Kigazuto/A-quadruped-robot-designed-based-on-a-crank-rocker-mechanism/README.md

# A-quadruped-robot-designed-based-on-a-crank-rocker-mechanism
