Kigazuto/A-quadruped-robot-designed-based-on-a-crank-rocker-mechanism/模型/蜘蛛/带传动/带传动.SLDASM

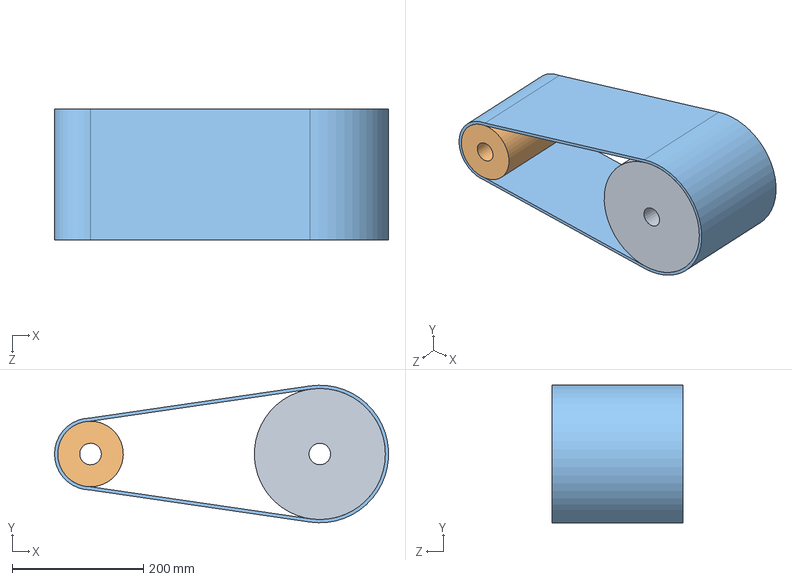
[picture p19: CAD file, 2024-10-21]
模型/蜘蛛/带传动/带传动.SLDASM
509.8 x 210.0 x 200.0 mm
摩擦带
从动轮
主动轮
