Kigazuto/A-quadruped-robot-designed-based-on-a-crank-rocker-mechanism/模型/四足/装配体2.SLDASM

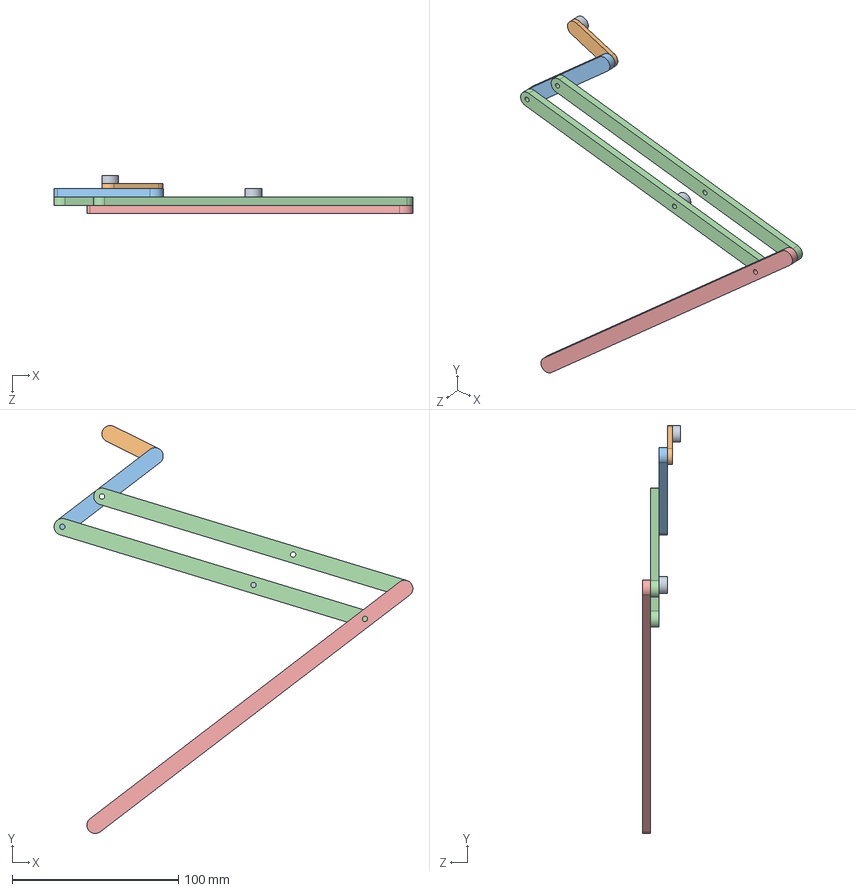
[picture p20: CAD file, 2024-10-21]
模型/四足/装配体2.SLDASM
215.6 x 245.1 x 23.0 mm
固定 x 2
零件1
零件2
零件3 x 2
零件4
