Kigazuto/A-quadruped-robot-designed-based-on-a-crank-rocker-mechanism/模型/蜘蛛/结构简图/草图.SLDASM

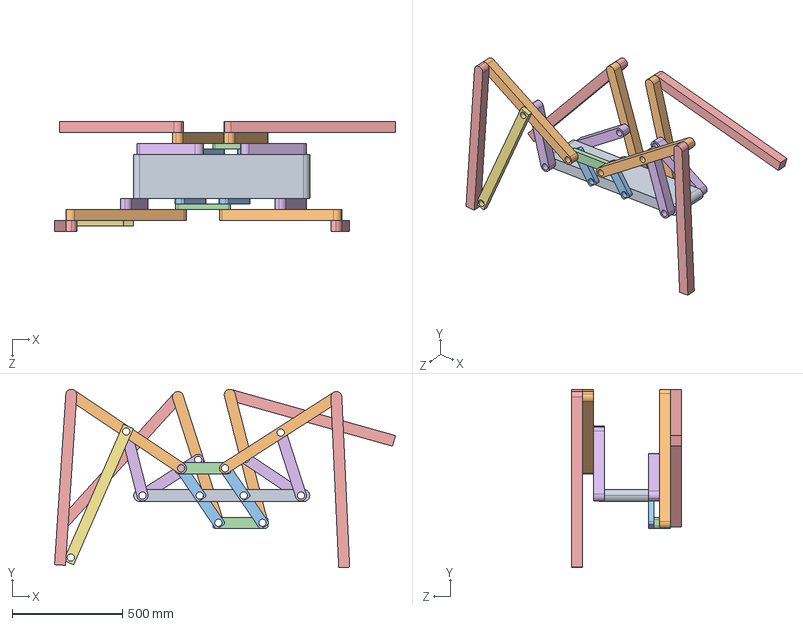
[picture p21: CAD file, 2024-10-21]
模型/蜘蛛/结构简图/草图.SLDASM
1548.7 x 810.5 x 500.0 mm
连杆1
连杆5 x 4
连杆2 x 4
连杆三 x 2
腿 x 4
连杆4 x 4
