Kigazuto/A-quadruped-robot-designed-based-on-a-crank-rocker-mechanism/模型/四足/装配体3.SLDASM

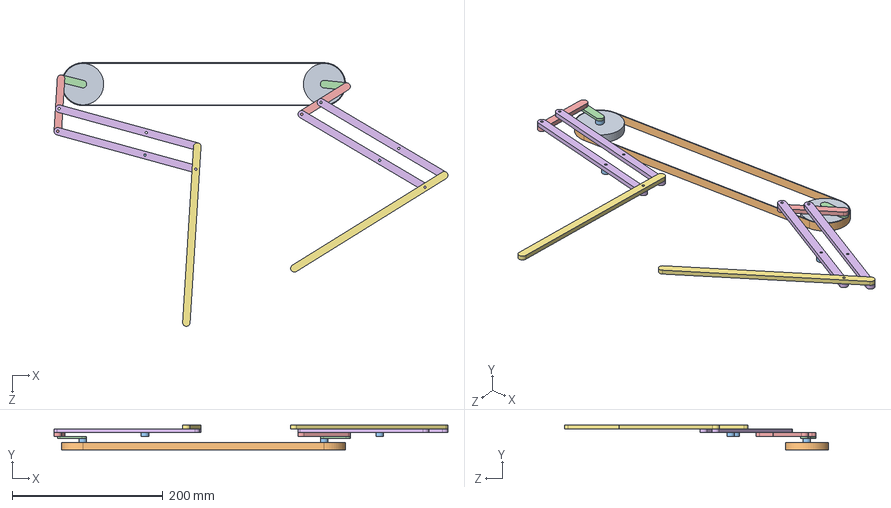
[picture p22: CAD file, 2024-10-21]
模型/四足/装配体3.SLDASM
522.8 x 33.0 x 349.8 mm
轮 x 2
带
固定 x 4
零件1 x 2
零件2 x 2
零件3 x 4
零件4 x 2
