Kigazuto/A-quadruped-robot-designed-based-on-a-crank-rocker-mechanism/模型/四足/装配体1.SLDASM

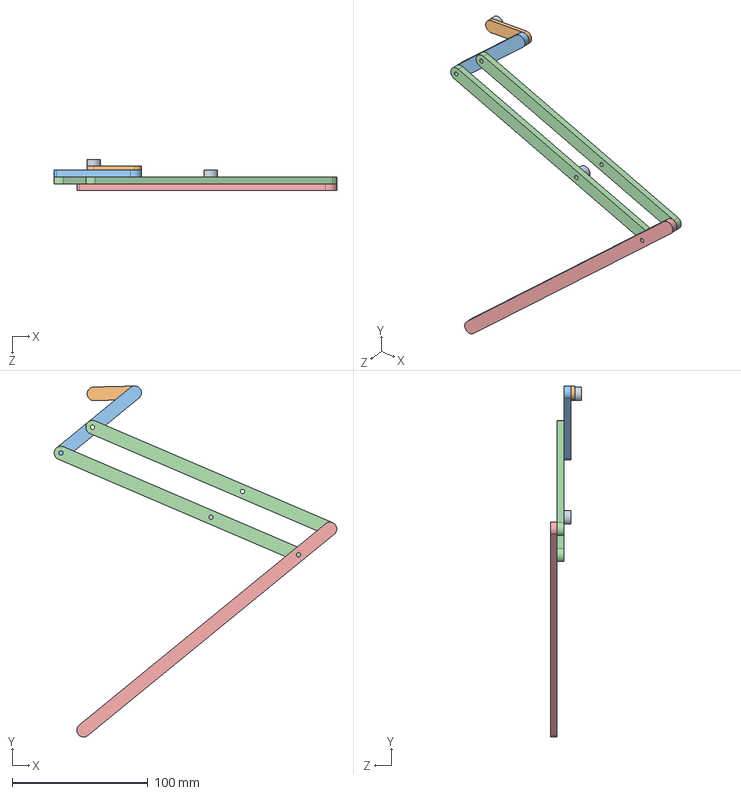
[picture p23: CAD file, 2024-10-21]
模型/四足/装配体1.SLDASM
207.9 x 258.2 x 23.0 mm
固定 x 2
零件1
零件2
零件3 x 2
零件4
