Kigazuto/A-quadruped-robot-designed-based-on-a-crank-rocker-mechanism/模型/蜘蛛/带传动/主动轮.SLDPRT

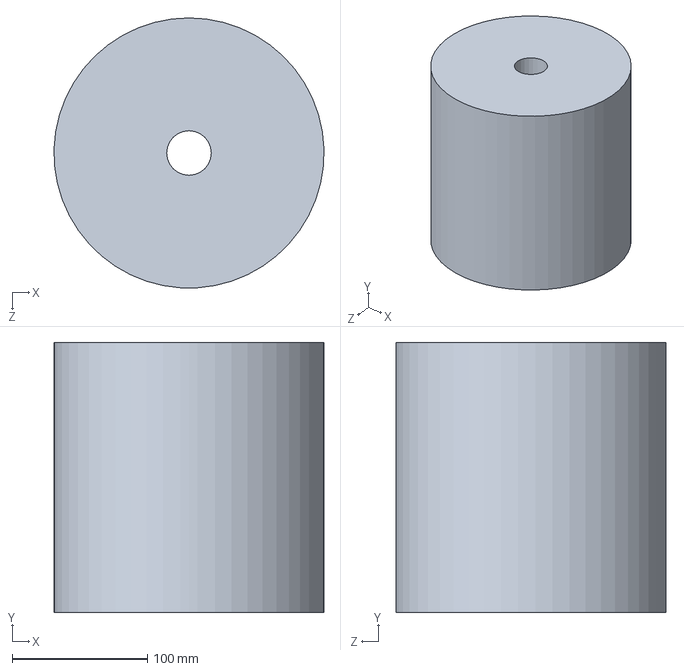
[picture p25: CAD file, 2024-10-21]
模型/蜘蛛/带传动/主动轮.SLDPRT
199.9 x 200.0 x 200.0 mm
