Kigazuto/A-quadruped-robot-designed-based-on-a-crank-rocker-mechanism/模型/蜘蛛/齿轮传动/齿轮84.SLDPRT

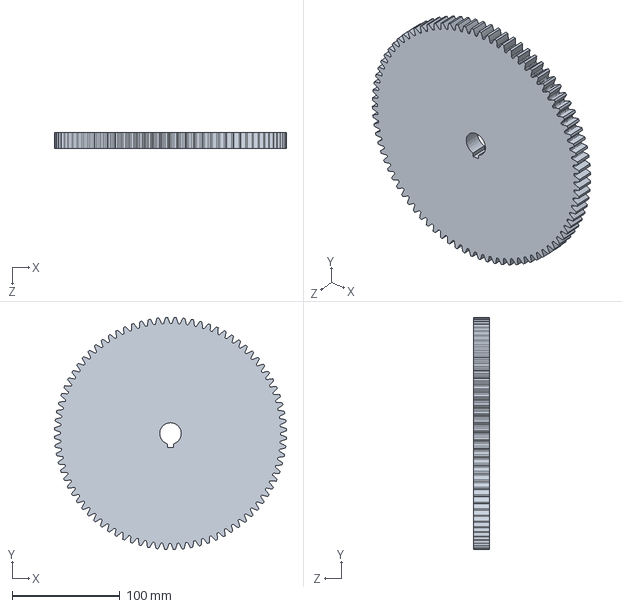
[picture p27: CAD file, 2024-10-21]
模型/蜘蛛/齿轮传动/齿轮84.SLDPRT
214.9 x 214.9 x 15.0 mm
