Kigazuto/A-quadruped-robot-designed-based-on-a-crank-rocker-mechanism/模型/四足/零件2.SLDPRT

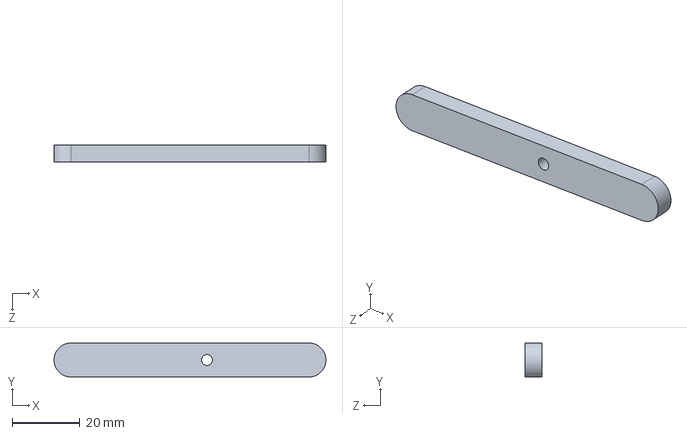
[picture p28: CAD file, 2024-10-21]
模型/四足/零件2.SLDPRT
80.0 x 10.0 x 5.00 mm
