Kigazuto/A-quadruped-robot-designed-based-on-a-crank-rocker-mechanism/模型/蜘蛛/带传动/从动轮.SLDPRT

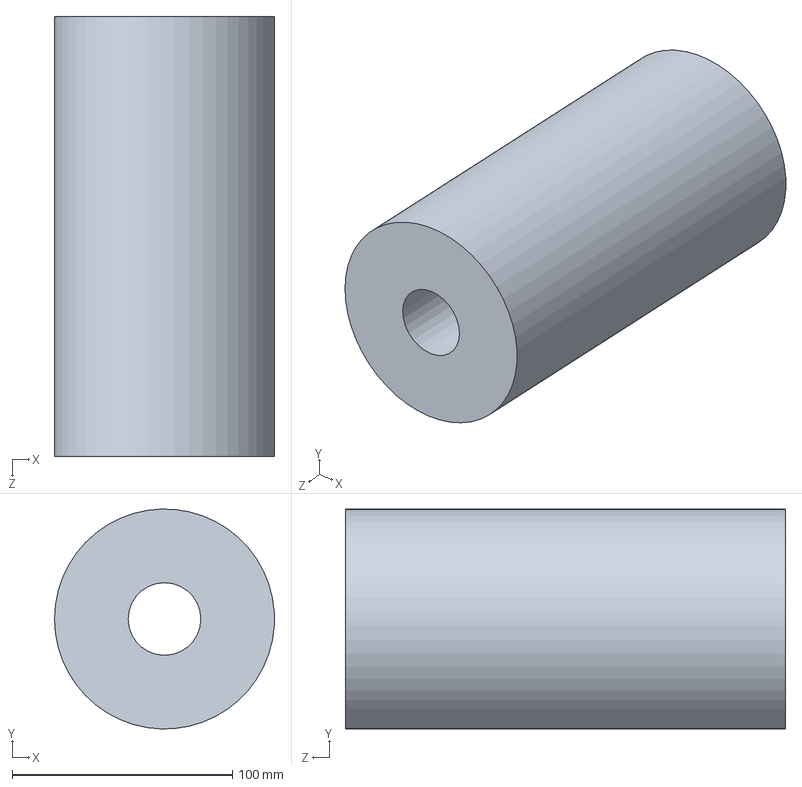
[picture p29: CAD file, 2024-10-21]
模型/蜘蛛/带传动/从动轮.SLDPRT
100.0 x 99.9 x 200.0 mm
