Kigazuto/A-quadruped-robot-designed-based-on-a-crank-rocker-mechanism/模型/蜘蛛/齿轮传动/齿轮42 .SLDPRT

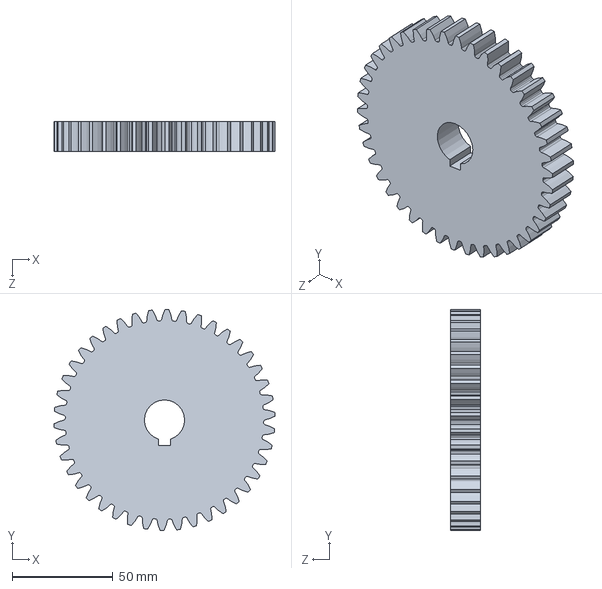
[picture p31: CAD file, 2024-10-21]
模型/蜘蛛/齿轮传动/齿轮42 .SLDPRT
109.9 x 110.0 x 15.0 mm
