Kigazuto/A-quadruped-robot-designed-based-on-a-crank-rocker-mechanism/模型/四足/轮.SLDPRT

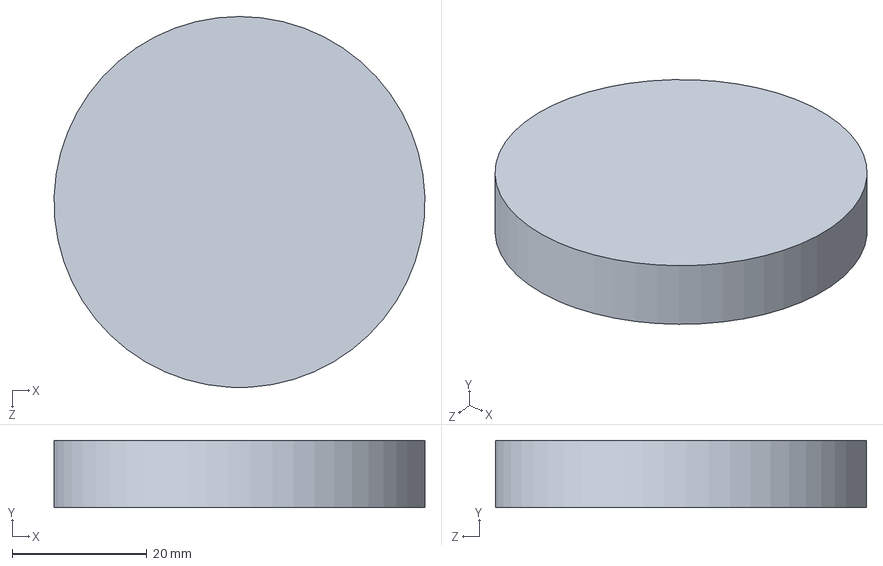
[picture p32: CAD file, 2024-10-21]
模型/四足/轮.SLDPRT
55.0 x 10.0 x 55.0 mm
