Kigazuto/A-quadruped-robot-designed-based-on-a-crank-rocker-mechanism/模型/蜘蛛/带传动/摩擦带.SLDPRT

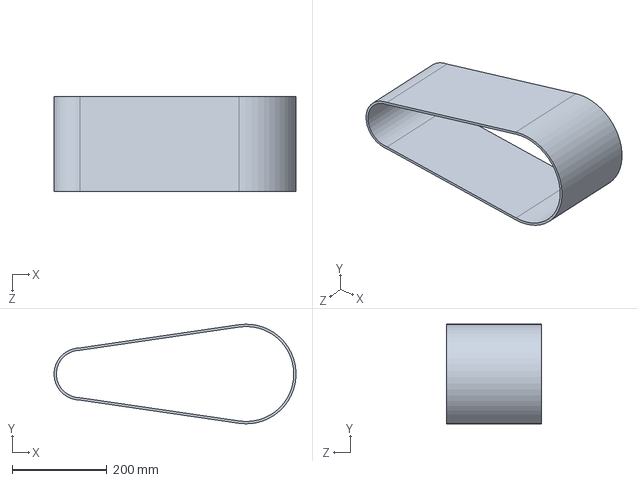
[picture p33: CAD file, 2024-10-21]
模型/蜘蛛/带传动/摩擦带.SLDPRT
509.8 x 210.0 x 200.0 mm
