Kigazuto/A-quadruped-robot-designed-based-on-a-crank-rocker-mechanism/模型/蜘蛛/结构简图/腿.SLDPRT

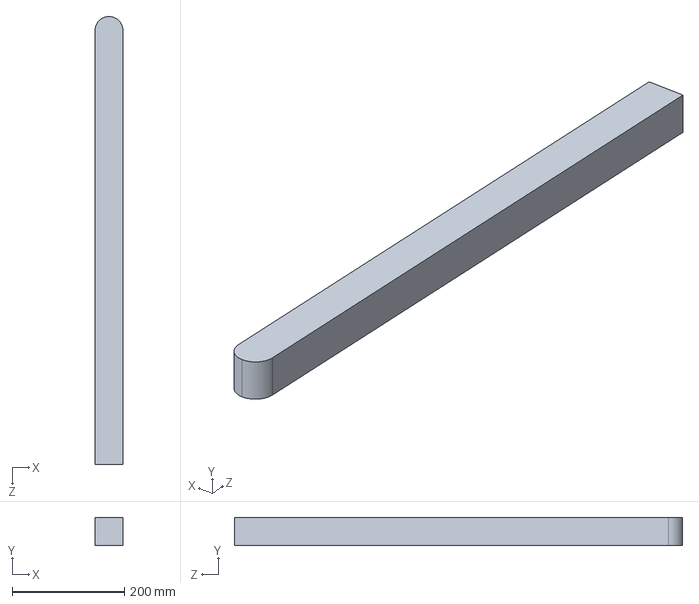
[picture p34: CAD file, 2024-10-21]
模型/蜘蛛/结构简图/腿.SLDPRT
50.0 x 50.0 x 800.0 mm
