Kigazuto/A-quadruped-robot-designed-based-on-a-crank-rocker-mechanism/模型/四足/零件1.SLDPRT

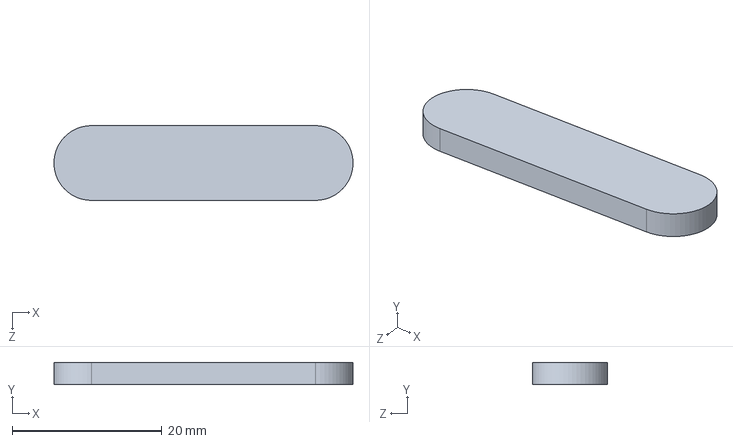
[picture p35: CAD file, 2024-10-21]
模型/四足/零件1.SLDPRT
40.0 x 3.00 x 10.0 mm
