Kigazuto/A-quadruped-robot-designed-based-on-a-crank-rocker-mechanism/模型/蜘蛛/结构简图/连杆6.SLDPRT

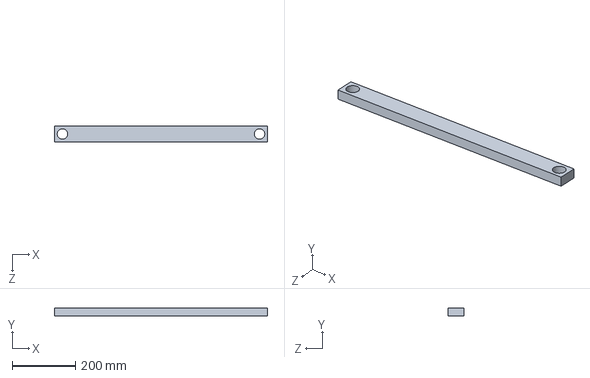
[picture p36: CAD file, 2024-10-21]
模型/蜘蛛/结构简图/连杆6.SLDPRT
675.0 x 25.0 x 50.0 mm
