Kigazuto/A-quadruped-robot-designed-based-on-a-crank-rocker-mechanism/模型/蜘蛛/结构简图/连杆4.SLDPRT

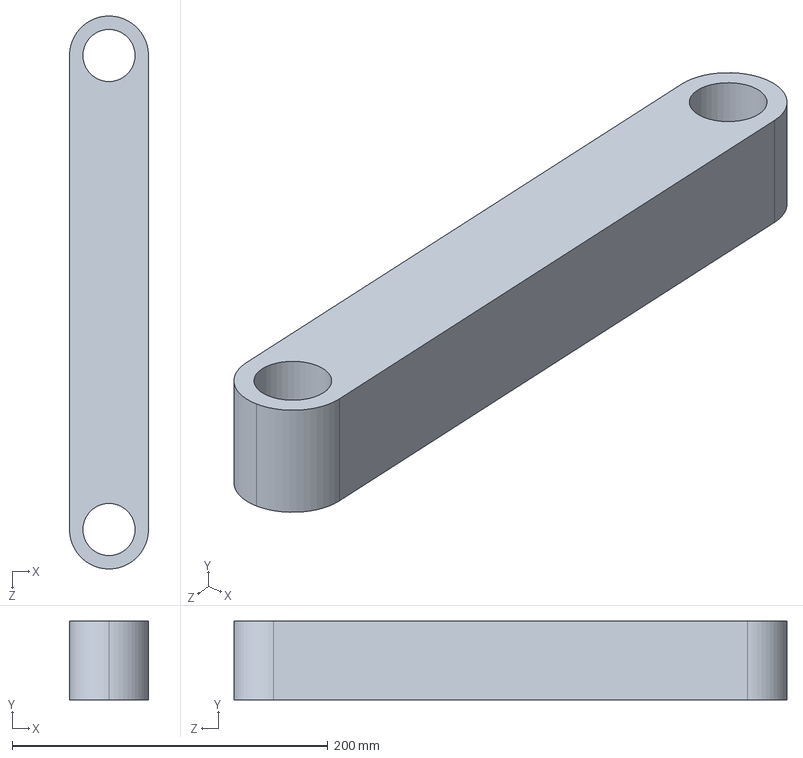
[picture p37: CAD file, 2024-10-21]
模型/蜘蛛/结构简图/连杆4.SLDPRT
50.0 x 50.0 x 350.0 mm
