Kigazuto/A-quadruped-robot-designed-based-on-a-crank-rocker-mechanism/模型/四足/零件4.SLDPRT

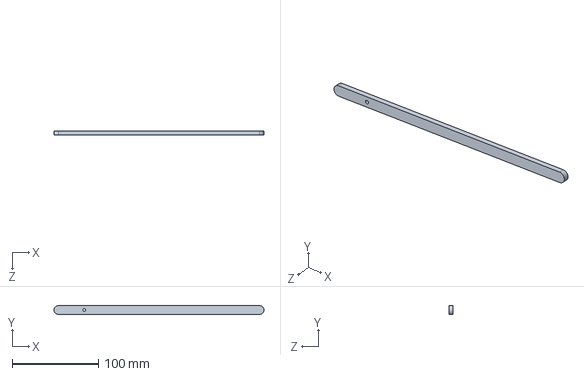
[picture p38: CAD file, 2024-10-21]
模型/四足/零件4.SLDPRT
244.0 x 10.0 x 5.00 mm
