Kigazuto/A-quadruped-robot-designed-based-on-a-crank-rocker-mechanism/模型/蜘蛛/结构简图/连杆5.SLDPRT

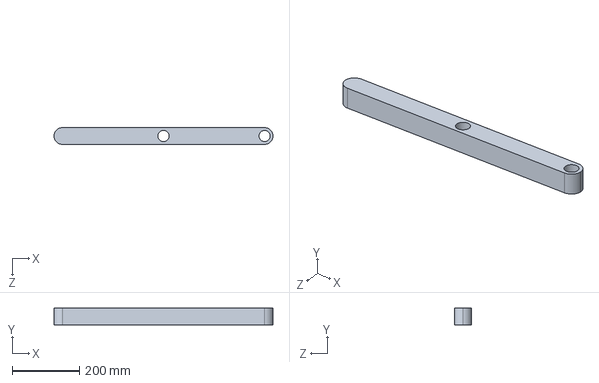
[picture p39: CAD file, 2024-10-21]
模型/蜘蛛/结构简图/连杆5.SLDPRT
650.0 x 50.0 x 50.0 mm
