Kigazuto/A-quadruped-robot-designed-based-on-a-crank-rocker-mechanism/模型/四足/固定.SLDPRT

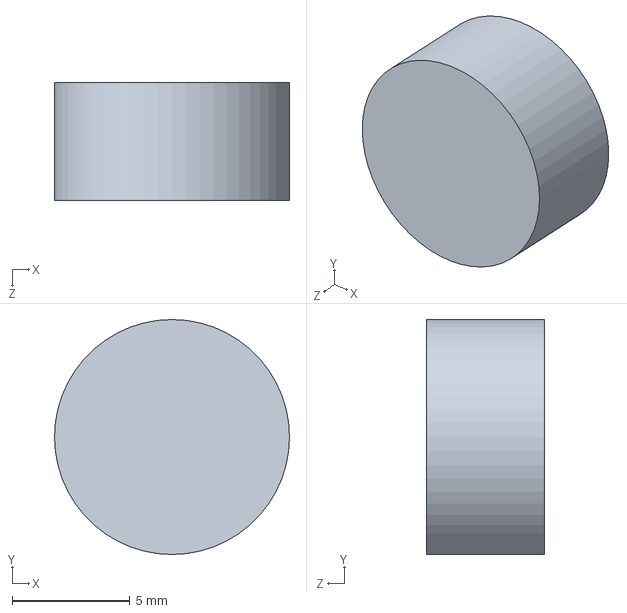
[picture p40: CAD file, 2024-10-21]
模型/四足/固定.SLDPRT
10.0 x 10.0 x 5.00 mm
