Kigazuto/A-quadruped-robot-designed-based-on-a-crank-rocker-mechanism/模型/蜘蛛/结构简图/连杆1.SLDPRT

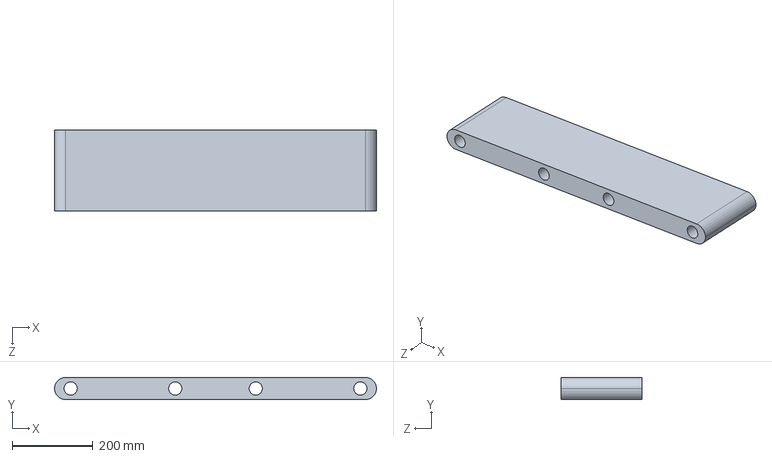
[picture p41: CAD file, 2024-10-21]
模型/蜘蛛/结构简图/连杆1.SLDPRT
800.0 x 55.0 x 200.0 mm
