Kigazuto/A-quadruped-robot-designed-based-on-a-crank-rocker-mechanism/模型/蜘蛛/结构简图/连杆2.SLDPRT

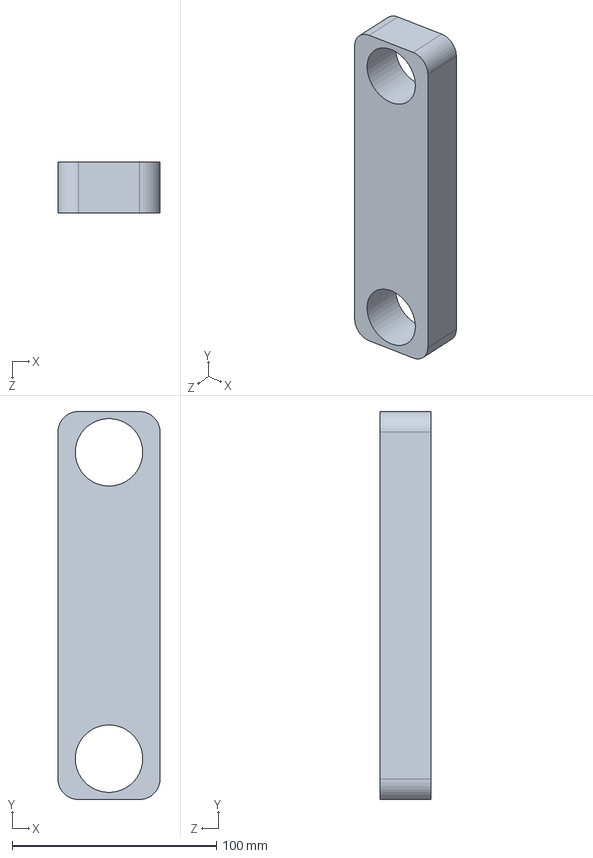
[picture p42: CAD file, 2024-10-21]
模型/蜘蛛/结构简图/连杆2.SLDPRT
50.0 x 190.0 x 25.0 mm
