Kigazuto/A-quadruped-robot-designed-based-on-a-crank-rocker-mechanism/模型/四足/带.SLDPRT

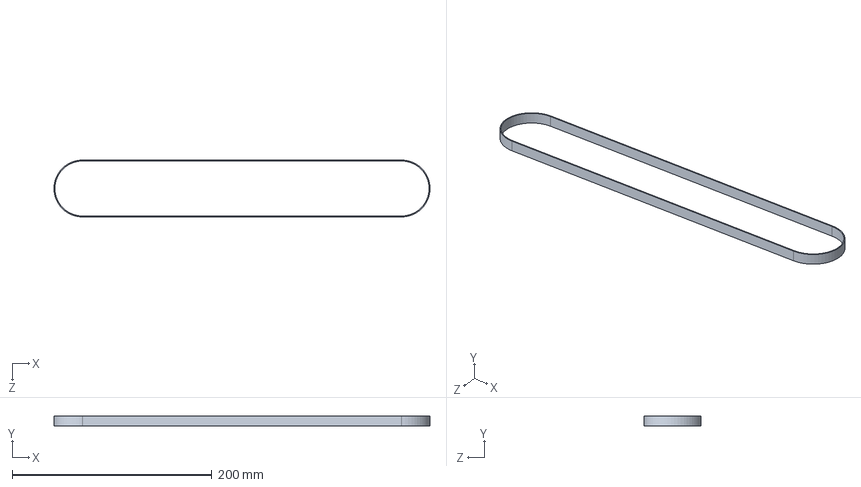
[picture p43: CAD file, 2024-10-21]
模型/四足/带.SLDPRT
376.9 x 10.0 x 57.0 mm
