Kigazuto/A-quadruped-robot-designed-based-on-a-crank-rocker-mechanism/模型/四足/固定2.SLDPRT

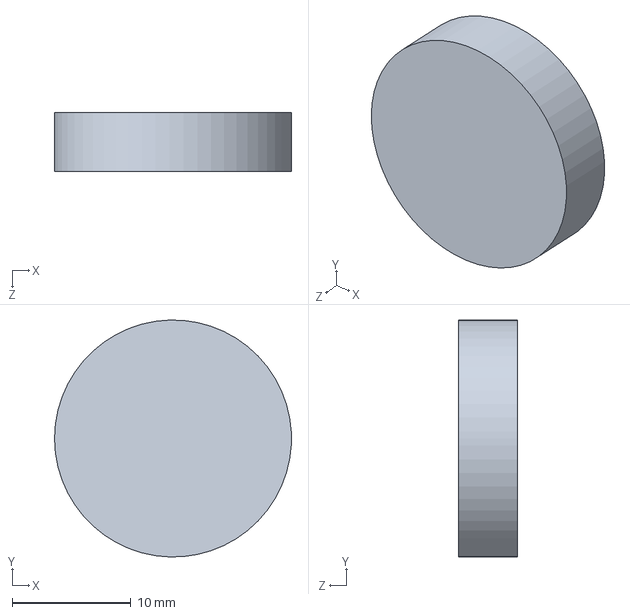
[picture p44: CAD file, 2024-10-21]
模型/四足/固定2.SLDPRT
20.0 x 20.0 x 5.00 mm
