Kigazuto/A-quadruped-robot-designed-based-on-a-crank-rocker-mechanism/(list of files, cad)

Other CAD files:
模型/结构简图/方案二.SLDPRT
模型/结构简图/修改后.SLDPRT
模型/结构简图/方案一.SLDPRT
模型/蜘蛛/齿轮传动/齿轮42.SLDPRT
